NoirsCodingCorner/espspe/Paper/augendiagram.jpeg

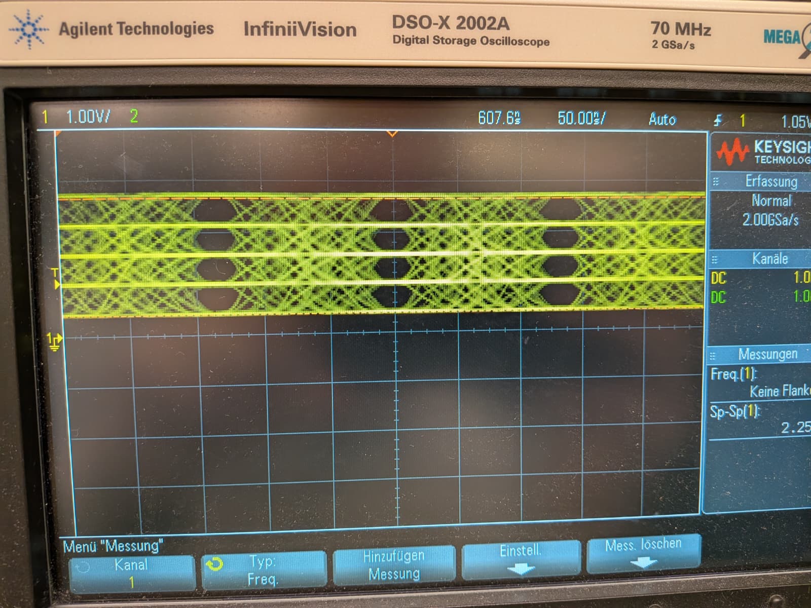
Paper/augendiagram.jpeg
