NoirsCodingCorner/espspe/Paper/blinkled.jpeg

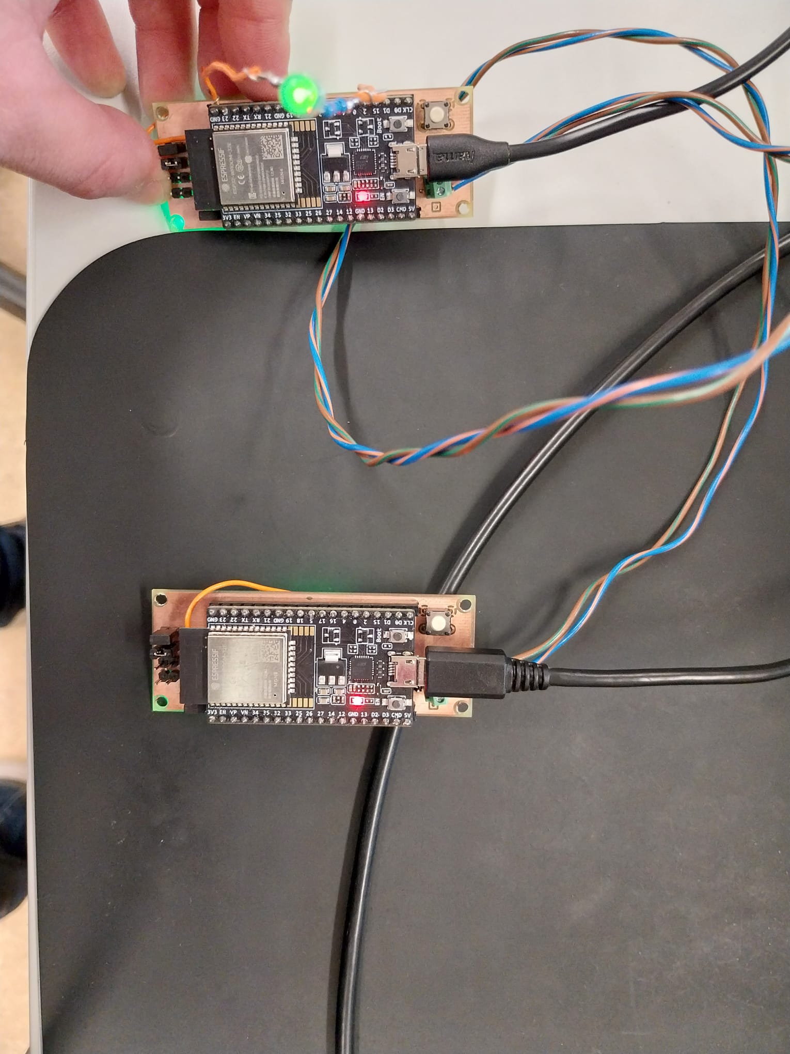
Paper/blinkled.jpeg
