NoirsCodingCorner/espspe/Paper/Presentation/ESPSPE.html

# 10BASE-T1L Interface

ESP32 & ADIN1110 Integration

Kurs Schaltungstechnik 2

Status Abschlussbericht

## Die "Last Mile" Problematik

### Ist-Zustand

In der Industrie 4.0 stoßen gängige Standards an ihre Grenzen:

- WLAN/Bluetooth: Unzuverlässig durch Interferenzen (Metallhallen) & Sicherheitsbedenken.
- Standard-Ethernet: Begrenzt auf 100m, benötigt 4-8 Adern (schweres Kabel).

### Unsere Lösung: SPE

10BASE-T1L (Single Pair Ethernet) schließt die Lücke:

- Nur ein verdrilltes Adernpaar (leicht, günstig).
- Reichweite bis zu 1000 Meter.
- Ziel: Kosteneffiziente IoT-Nodes (ESP32) industrietauglich machen.

## Hardware Architektur

### MCU: ESP32-DevKitC

- Verantwortlich für Applikationslogik & High-Level Stack.
- Versorgung: Speist die PHY-IO-Logik mit 3.3V.
- Vorteil: Direkte Pegel-Kompatibilität ohne Level-Shifter.

### PHY: ADIN1110

- Ultra-Low Power MAC-PHY von Analog Devices.
- Timing: Autonomer 25 MHz Quarz für stabile Clock.
- Interface: Anbindung via SPI an den ESP32.

### Safety Feature

Galvanische Trennung durch Isolationstransformator am MDI.

PoE Safe

## Software Stack

### Treiber-Design

Entwickelt in PlatformIO / C++.

class SPIDevice { // Abstraktion der Hardware-Layer void beginTransaction(); };

### Protokoll-Entscheidung

- Generic SPI statt OPEN Alliance Protokoll.
- Reduzierter Overhead für die erste Implementierungsphase.
- Direkter Register-Zugriff zur Fehlerdiagnose.

## Validierung & Tests

### Erfolge

Verifiziert

- Spannungsversorgung (3.3V & 1.1V Core) stabil.
- 25 MHz Oszillator schwingt sauber an.
- ESP32 Master-Signale (Clock, MOSI) am Oszilloskop sichtbar.

### Kritischer Fehler

Blocker

Keine MISO Antwort: Der ADIN1110 reagiert nicht auf SPI-Befehle.

Trotz korrekter Eingangssignale bleibt die Ausgangsleitung hochohmig (High-Z).

## Fehleranalyse

Warum schweigt der Chip? Aktuelle Hypothesen:

### 1. Reset-Timing

Der Hardware-Reset Pin muss evtl. länger gehalten werden, damit die interne Power-On-Sequenz des ADIN1110 sauber durchläuft.

### 2. SPI Modus

Möglicher Mismatch bei CPOL/CPHA. Wenn der Chip Daten bei fallender Flanke erwartet, wir aber bei steigender senden, werden Befehle ignoriert.

Diagnose-Plan: Einsatz eines Logic Analyzers notwendig, um das Protokoll auf Bitebene mit dem Datasheet abzugleichen.

## Projekt-Status & Fazit

### Erreichtes

- Funktionsfähiges Custom-PCB Design (Power & Isolation).
- Hardware-Aufbau und elektrische Inbetriebnahme erfolgreich.
- Basis-Treiberstruktur in C++ implementiert.

### Offene Herausforderungen

Da das Projektsemester endet, bleiben folgende Punkte für eine Weiterführung offen:

- Debugging der SPI-Kommunikation (Low-Level).
- Anbindung an den ESP32 TCP/IP Stack.
- Performance-Tests über 1000m Kabel.

### Vielen Dank für Ihre Aufmerksamkeit.

❮ ❯
