NoirsCodingCorner/espspe/Pictures/ESP_32_WROOM_32.jpg

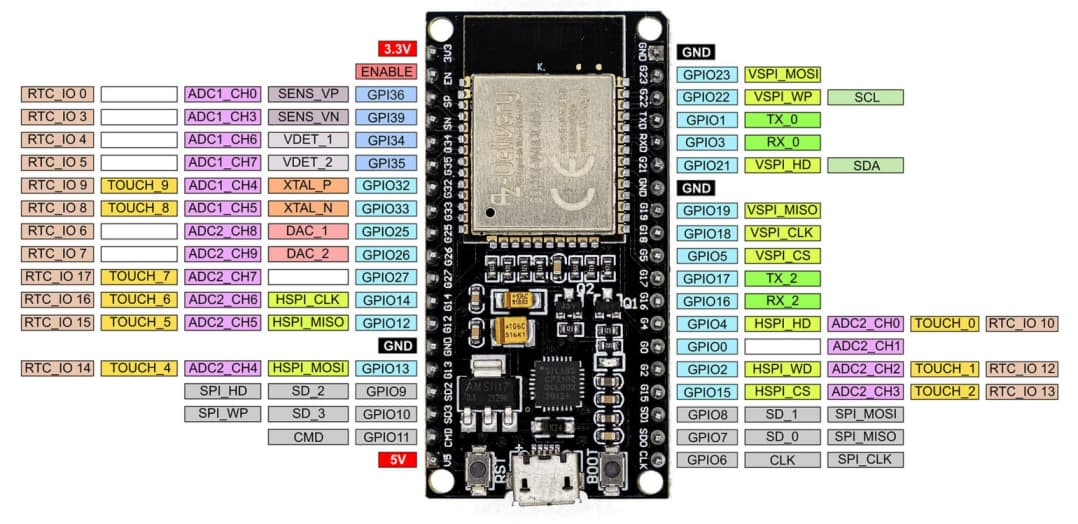
Pictures/ESP_32_WROOM_32.jpg
