NoirsCodingCorner/espspe/Scemetic/ESPSPE_Scemetic/ESPSPE_Scemetic.pdf

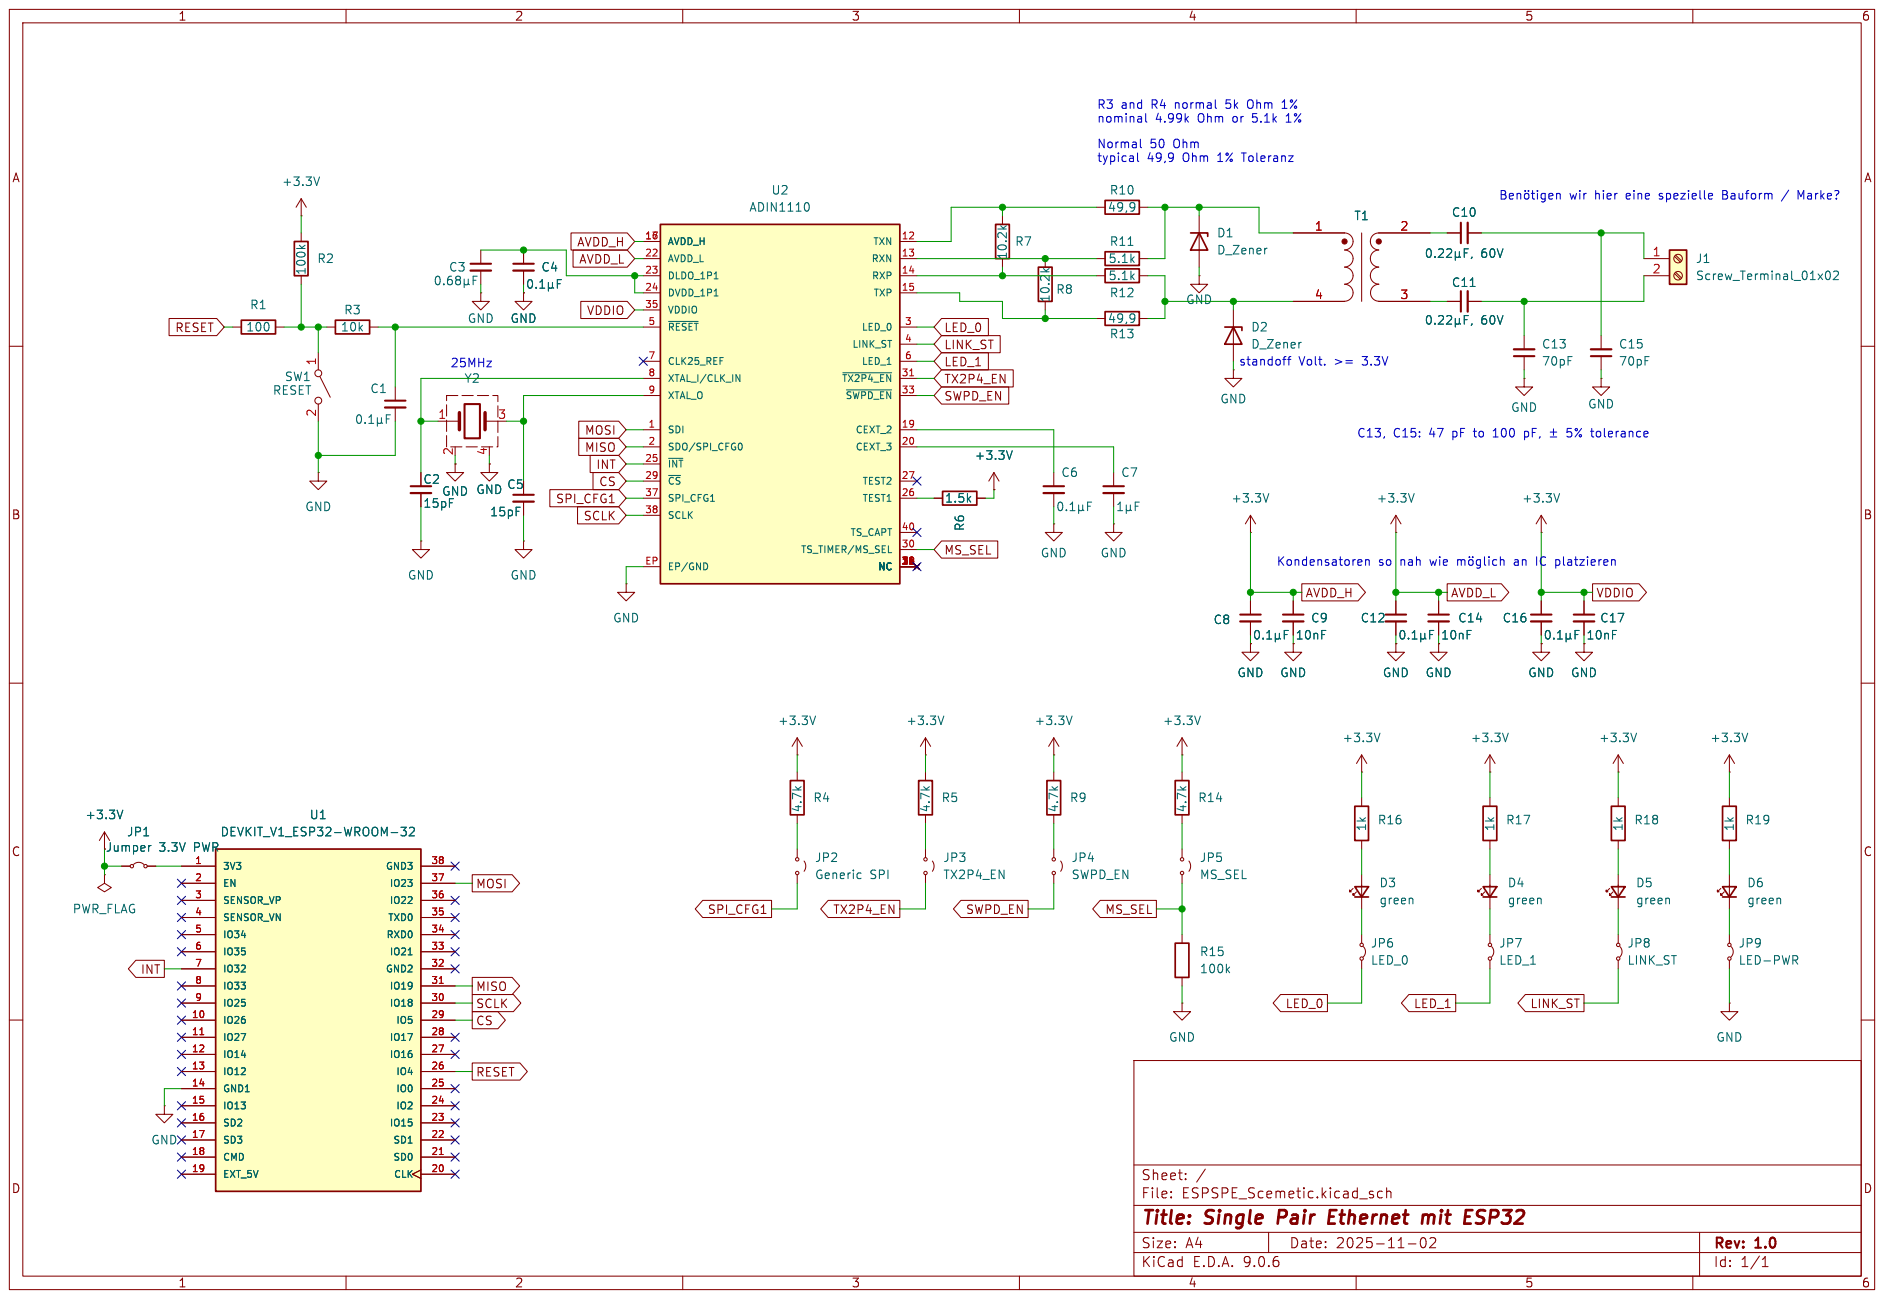
[picture p5: page 1]

File: ESPSPE_Scemetic.kicad_sch Sheet: /
Id: 1/1 Title: Single Pair Ethernet mit ESP32
