NoirsCodingCorner/espspe/Scemetic/ESPSPE_Scemetic/ESPSPE_Scemetic.kicad_pcb

## KiCad design Scemetic/ESPSPE_Scemetic/ESPSPE_Scemetic.kicad_pcb (2025-12-01)

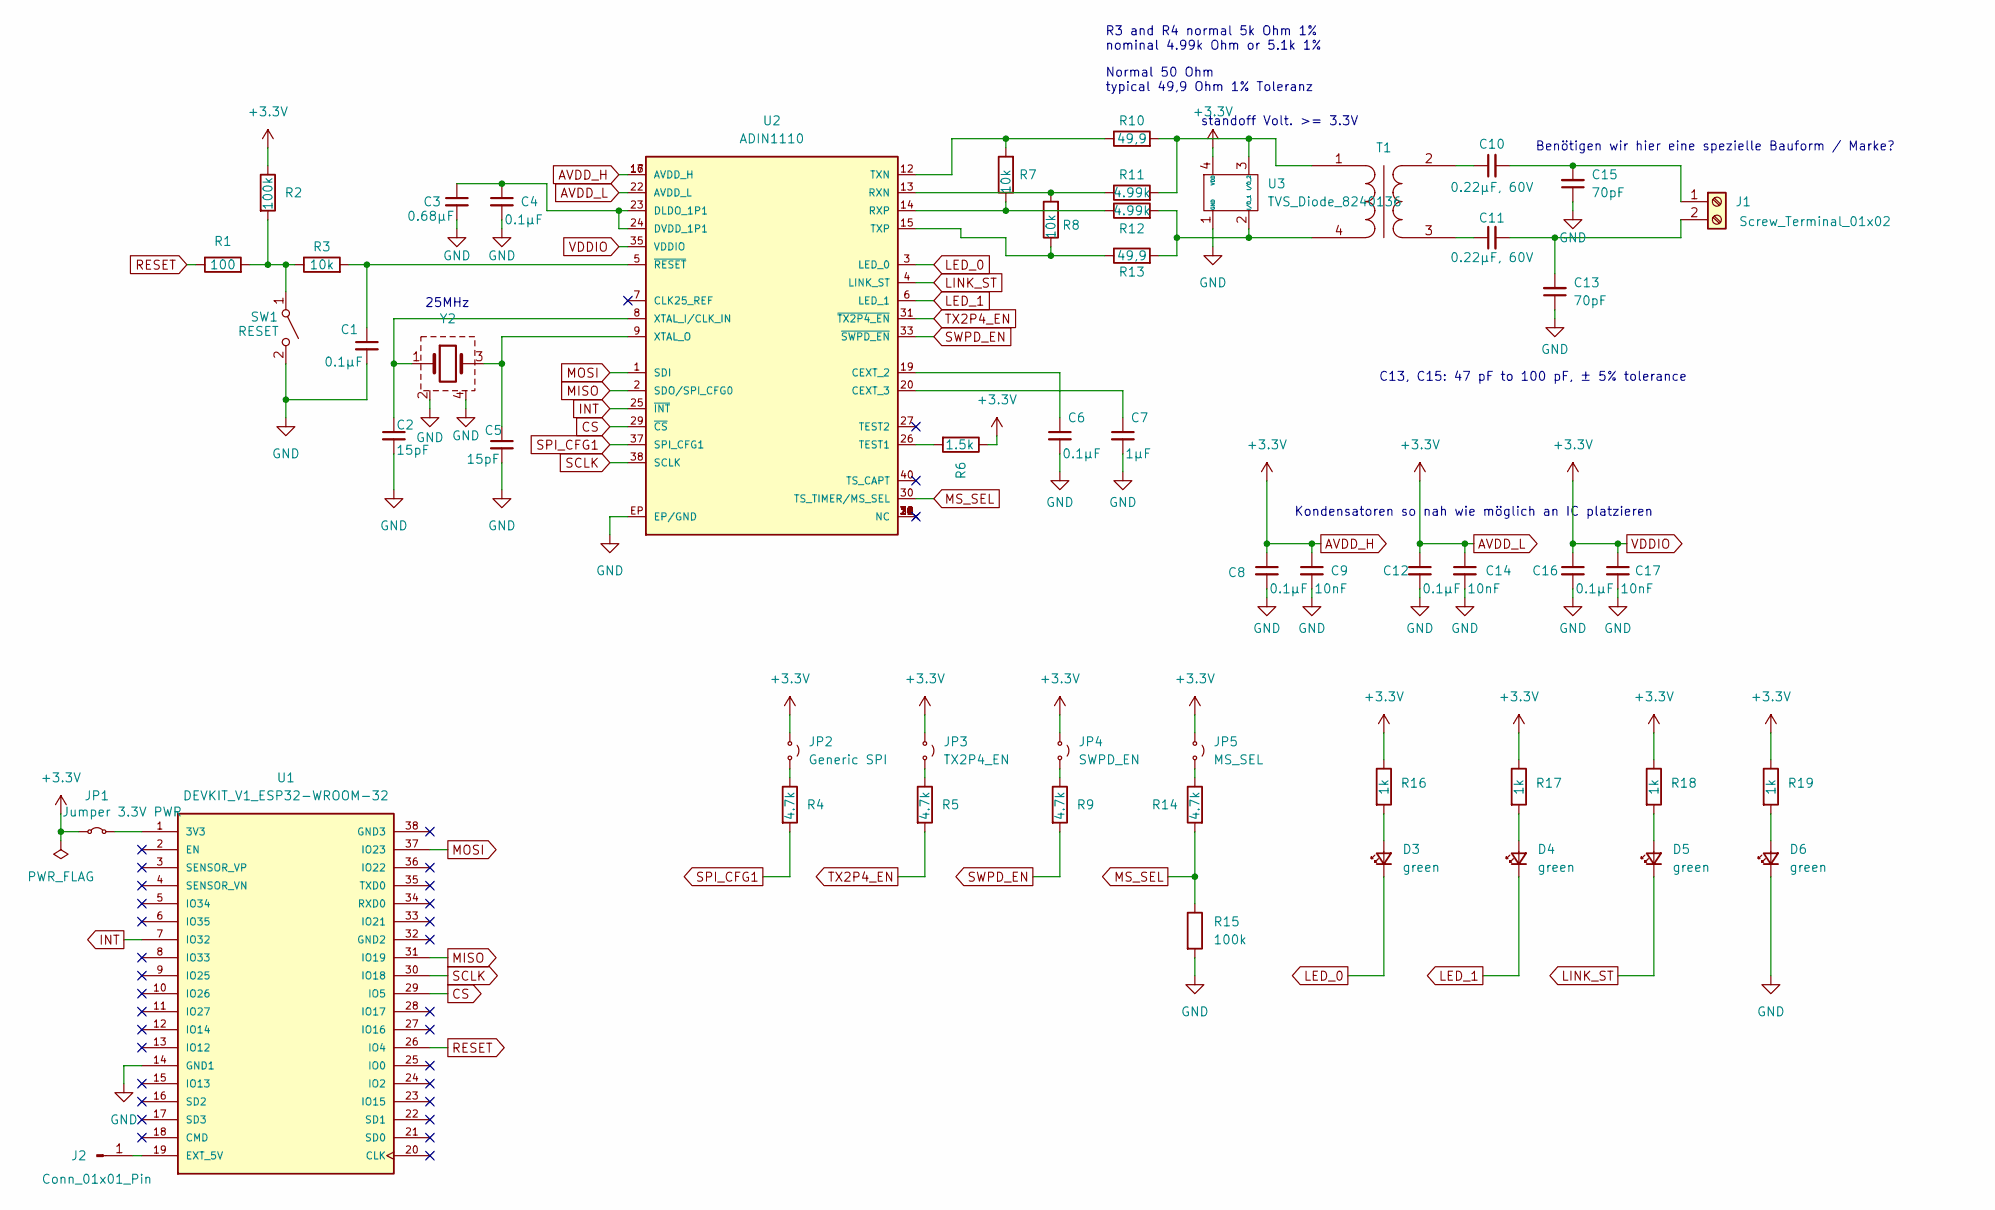
[picture p6: schematic ESPSPE_Scemetic.kicad_sch, Single Pair Ethernet mit ESP32]

Parts:
C1, C4, C6, C8, C12, C16: 0.1µF; C_0805_2012Metric_Pad1.18x1.45mm_HandSolder
C2, C5: 15pF; C_0805_2012Metric_Pad1.18x1.45mm_HandSolder
C3: 0.68µF; C_0805_2012Metric_Pad1.18x1.45mm_HandSolder
C7: 1µF; C_0805_2012Metric_Pad1.18x1.45mm_HandSolder
C9, C14, C17: 10nF; C_0805_2012Metric_Pad1.18x1.45mm_HandSolder
C10, C11: 0.22µF, 60V; C_0805_2012Metric_Pad1.18x1.45mm_HandSolder
C13, C15: 70pF; C_0805_2012Metric_Pad1.18x1.45mm_HandSolder
D3, D4, D5, D6: green; LED_0805_2012Metric_Pad1.15x1.40mm_HandSolder
J1: Screw_Terminal_01x02; TerminalBlock_Phoenix_MPT-0,5-2-2.54_1x02_P2.54mm_Horizontal
J2: Conn_01x01_Pin; PinHeader_1x01_P2.54mm_Vertical
JP1: Jumper 3.3V PWR; PinHeader_1x02_P2.54mm_Vertical
JP2: Generic SPI; PinHeader_1x02_P2.54mm_Vertical
JP3: TX2P4_EN; PinHeader_1x02_P2.54mm_Vertical
JP4: SWPD_EN; PinHeader_1x02_P2.54mm_Vertical
JP5: MS_SEL; PinHeader_1x02_P2.54mm_Vertical
R1: 100; R_0805_2012Metric_Pad1.20x1.40mm_HandSolder
R2, R15: 100k; R_0805_2012Metric_Pad1.20x1.40mm_HandSolder
R3, R7, R8: 10k; R_0805_2012Metric_Pad1.20x1.40mm_HandSolder
R4, R5, R9, R14: 4.7k; R_0805_2012Metric_Pad1.20x1.40mm_HandSolder
R6: 1.5k; R_0805_2012Metric_Pad1.20x1.40mm_HandSolder
R10, R13: 49,9; R_0603_1608Metric_Pad0.98x0.95mm_HandSolder
R11, R12: 4.99k; R_0603_1608Metric_Pad0.98x0.95mm_HandSolder
R16, R17, R18, R19: 1k; R_0805_2012Metric_Pad1.20x1.40mm_HandSolder
SW1: RESET; SW_PUSH_6mm
T1: 749070010; T_Wurth_WE-SPE_749070010; Part Number 749070010
U1: DEVKIT_V1_ESP32-WROOM-32; MODULE_DEVKIT_V1_ESP32-WROOM-32; PARTREV N/A
U2: ADIN1110; LFCSP-40
U3: TVS_Diode_8240136
Y2: CFPX-180_830105863709; Y_Wurth_WE-XTAL_Quartz-CFPX-180; Part Number 830105863709

Connections:
AVDD_H: C8.1, C9.1, C12.1, C14.1, C16.1, C17.1, JP1.1 (A), JP2.1 (A), JP3.1 (A), JP4.1 (A), JP5.1 (A), R2.1, R6.1, R16.1, R17.1, R18.1, R19.1, U2.16 (AVDD_H), U2.17 (AVDD_H), U2.22 (AVDD_L), U2.35 (VDDIO), U3.4 (VDD)
CS: U1.29 (IO5), U2.29 (~CS)
GND: C1.2, C2.2, C3.2, C4.2, C5.2, C6.2, C7.2, C8.2, C9.2, C12.2, C13.1, C14.2, C15.1, C16.2, C17.2, D6.1 (K), R15.2, SW1.2 (B), U1.14 (GND1), U2.EP (EP/GND), U3.1 (GND), Y2.2 (GND), Y2.4 (GND1)
INT: U1.7 (IO32), U2.25 (~INT)
LED_0: D3.1 (K), U2.3 (LED_0)
LED_1: D4.1 (K), U2.6 (LED_1)
LINK_ST: D5.1 (K), U2.4 (LINK_ST)
MISO: U1.31 (IO19), U2.2 (SDO/SPI_CFG0)
MOSI: U1.37 (IO23), U2.1 (SDI)
MS_SEL: R14.2, R15.1, U2.30 (TS_TIMER/MS_SEL)
unnamed: C10.1, T1.2
unnamed: C11.1, T1.3
unnamed: D3.2 (A), R16.2
unnamed: D4.2 (A), R17.2
unnamed: D5.2 (A), R18.2
unnamed: D6.2 (A), R19.2
unnamed: C10.2, C15.2, J1.1
unnamed: C11.2, C13.2, J1.2
unnamed: J2.1, U1.19 (EXT_5V)
unnamed: JP1.2 (B), U1.1 (3V3)
unnamed: JP2.2 (B), R4.1
unnamed: JP3.2 (B), R5.1
unnamed: JP4.2 (B), R9.1
unnamed: JP5.2 (B), R14.1
unnamed: R1.2, R2.2, R3.1, SW1.1 (A)
unnamed: C6.1, U2.19 (CEXT_2)
unnamed: C7.1, U2.20 (CEXT_3)
unnamed: C3.1, C4.1, U2.23 (DLDO_1P1), U2.24 (DVDD_1P1)
unnamed: R8.2, R11.1, U2.13 (RXN)
unnamed: R7.1, R12.1, U2.14 (RXP)
unnamed: R6.2, U2.26 (TEST1)
unnamed: R7.2, R10.1, U2.12 (TXN)
unnamed: R8.1, R13.1, U2.15 (TXP)
unnamed: C2.1, U2.8 (XTAL_I/CLK_IN), Y2.1
unnamed: C5.1, U2.9 (XTAL_O), Y2.3
unnamed: C1.1, R3.2, U2.5 (~RESET)
unnamed: R12.2, R13.2, T1.4, U3.2 (I/O_1)
unnamed: R10.2, R11.2, T1.1, U3.3 (I/O_2)
RESET: R1.1, U1.26 (IO4)
SCLK: U1.30 (IO18), U2.38 (SCLK)
SPI_CFG1: R4.2, U2.37 (SPI_CFG1)
SWPD_EN: R9.2, U2.33 (~SWPD_EN)
TX2P4_EN: R5.2, U2.31 (~TX2P4_EN)

Notes on the sheet:
Kondensatoren so nah wie möglich an IC platzieren
Normal 50 Ohm typical 49,9 Ohm 1% Toleranz
25MHz
R3 and R4 normal 5k Ohm 1% nominal 4.99k Ohm or 5.1k 1%
standoff Volt. >= 3.3V
Benötigen wir hier eine spezielle Bauform / Marke?
C13, C15: 47 pF to 100 pF, ± 5% tolerance

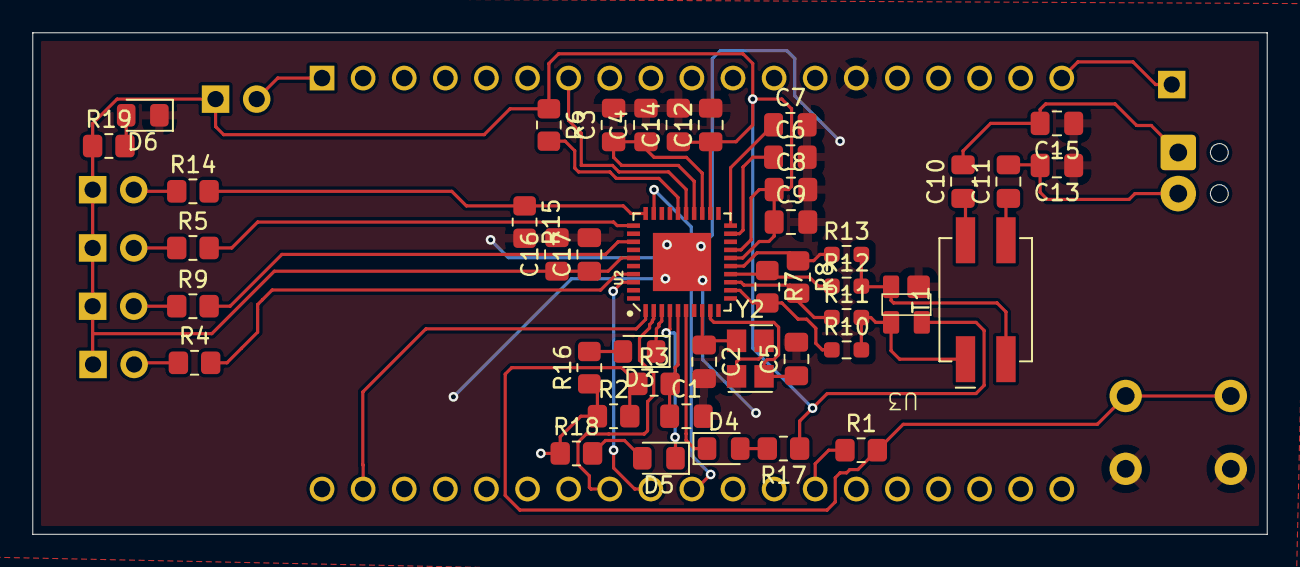
[picture p7: board ESPSPE_Scemetic.kicad_pcb from above]

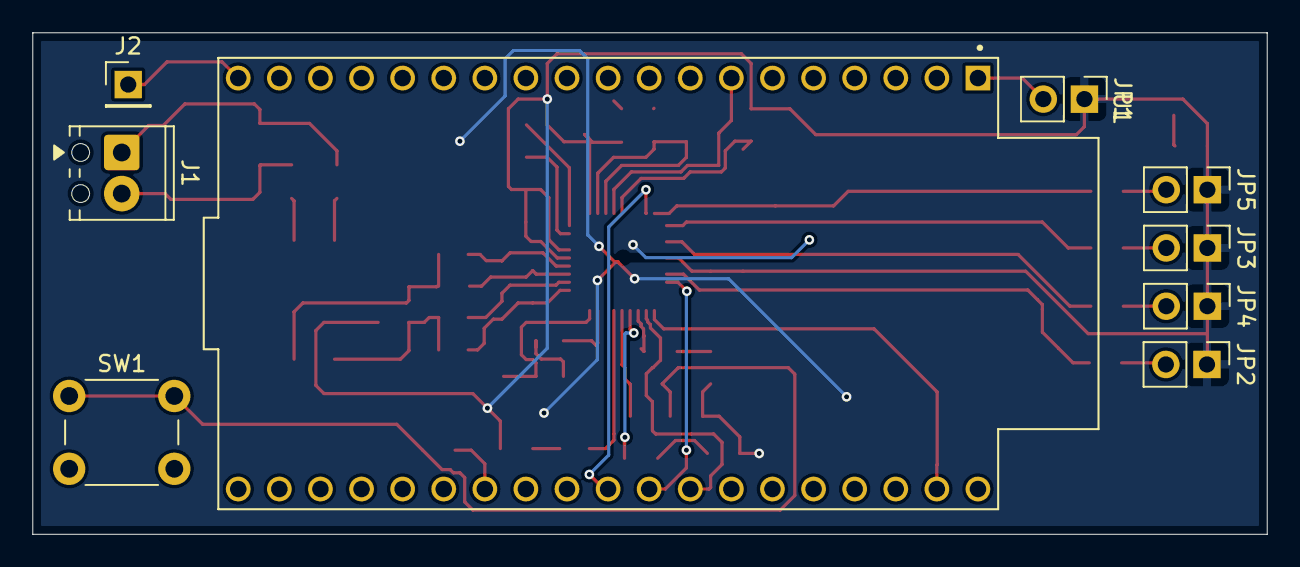
[picture p8: board ESPSPE_Scemetic.kicad_pcb from below]

Board: 2 copper layers, 76.3 x 31.0 mm, 53 parts (9 on the bottom side), 43 nets.
