NoirsCodingCorner/espspe/(commit log)

2025-11-02 I added a Pin Map; I added a KiCad Projekt with semetic, it's not finished yet; I added the adin1110 Datasheet with coments
    [ESPSPE_Scemetic.kicad_pcb, ESPSPE_Scemetic.kicad_sch, PIN_Conection_IO_Map.xlsx]
2025-11-03 Add pwm_stresstest code
2025-11-04 added ESP Pinout; Update of Scemetic -> should be ready to search for components
    [ESPSPE_Scemetic.kicad_sch]
2025-11-11 Schaltplan vollständig
    [ESPSPE_Scemetic.kicad_sch]
2025-11-11 Datenblatt von Transformator und Oszillator hinzugefügt
2025-11-11 Schaltplan Footprintzuweisung angefangen
    [ESPSPE_Scemetic.kicad_sch]
2025-11-15 Jumper für PWR LED entfernt. Footprint für Traffo und Quartz zugewiesen. Z_Diode 0805 zugewiesen. Platine angefangen zu zeichen -> Bauteile angeordnet
    [ESPSPE_Scemetic.kicad_pcb, ESPSPE_Scemetic.kicad_sch]
2025-11-16 Jumper der LEDs entfernt
    [ESPSPE_Scemetic.kicad_pcb, ESPSPE_Scemetic.kicad_sch]
2025-11-16 Platine bis auf GND geroutet
    [ESPSPE_Scemetic.kicad_pcb]
2025-11-17 Z Dioden hinzugefügt
    [ESPSPE_Scemetic.kicad_pcb, ESPSPE_Scemetic.kicad_sch]
2025-11-17 Schönifizierung des Netzwerkes; Dioden THT zu SMD gewechselt
    [ESPSPE_Scemetic.kicad_pcb, ESPSPE_Scemetic.kicad_sch]
2025-11-29 Platine Bauteile kompakter angeordnet
    [ESPSPE_Scemetic.kicad_pcb, ESPSPE_Scemetic.kicad_sch]
2025-12-01 Vias eingefügt
    [ESPSPE_Scemetic.kicad_pcb, ESPSPE_Scemetic.kicad_sch]
2025-12-01 Bestellliste erstellt, Schaltplanänderung angepasst.
    [ESPSPE_Scemetic.csv, ESPSPE_Scemetic.kicad_pcb, ESPSPE_Scemetic.kicad_sch, ESPSPE_Scemetic_SaftyAdjusted.csv]
2026-01-10 feat: initial commit of ADIN1110 driver skeleton and conference paper
2026-01-12 test(adin1110): Brute-Force SPI Protokoll-Scanner hinzugefügt
    - Implementiert Endlosschleife, die zwischen Open Alliance und Generic SPI wechselt
    - Fügt Software-Strapping hinzu, um MISO (CFG0) während des Resets auf High/Low zu zwingen
    - Dient zur Diagnose der MISO-Leitung und Überprüfung der Chip-Reaktion
    - Ermöglichte die Identifikation des fehlenden SCLK-Signals (via MISO Active-Low Verhalten)
    [main.cpp]
2026-01-13 feat: Implement ADIN1110 diagnostics tool & Generic SPI driver
    This commit introduces a comprehensive diagnostic tool for the ADIN1110
    MAC-PHY to validate hardware connectivity and SPI communication.
    Key changes:
    - Implemented Generic SPI protocol driver (Mode 0) with CRC8 calculation.
    - Added MDIO bridge access to read internal PHY registers via MAC SPI.
    - Implemented polling mechanism for MDIO TRDONE (transaction done) bit.
    - Added readable decoding for:
    - MAC Registers (ID, Status, IRQ Mask).
    - PHY Registers (Link Status, Signal Quality/MSE, LED Control).
    - Fixed SPI read/write timing and command structure according to datasheet.
    Hardware context:
    - Validated on ESP32-S3 with ADIN11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
    [main.cpp]
2026-01-19 feat: Implementierung Packet-Engine und Register-Definitionen
2026-01-19 fix: ADIN1110 Kommunikation repariert (Generic SPI + CRC + Padding)
    [main.cpp]
2026-01-19 feat: fix SPI communication (enable HW-CRC & promiscuous mode)
    - Enable ADIN1110 CRC_APPEND (hardware FCS generation) to fix packet drops
    - Enable Promiscuous Mode to bypass strict MAC filtering
    - Optimize SPI transactions (DMA block transfer) to eliminate clock gaps
    - Verify stable link with correct payload reception
    [main.cpp]
2026-01-22 working blinking LED
